me-chiel/MagicWandMod/Software/ESP8266-Hitachi/ESP8266-Hitachi.ino

/*********
  Rui Santos
  Complete project details at https://RandomNerdTutorials.com/esp32-esp8266-web-server-outputs-momentary-switch/
  
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
  The above copyright notice and this permission notice shall be included in all
  copies or substantial portions of the Software.
*********/

/*
Me-Chiel:
This should be possible with an ESP 01S and some extra components.
Maybe in the future I'll have a go at integrating this completely in the Magic Wand.
Added two extra buttons to control the Magic Wand in this sofware.
Be aware, the signals from the Wand are pulled up high to 5V. 
you cannot connect these directly to your ESP module.
*/

#ifdef ESP32
  #include <WiFi.h>
  #include <AsyncTCP.h>
#else
  #include <ESP8266WiFi.h>
  #include <ESPAsyncTCP.h>
#endif
#include <ESPAsyncWebServer.h>
#include "credentials.h"

// REPLACE WITH YOUR NETWORK CREDENTIALS
const char* ssid = WiFi_ssid;
const char* password = WiFi_password;

const int outputD4 = 2;
const int outputD2 = 4;
const int outputD1 = 5;

// HTML web page
const char index_html[] PROGMEM = R"rawliteral(
<!DOCTYPE HTML><html>
  <head>
    <title>ESP Pushbutton Web Server</title>
    <meta name="viewport" content="width=device-width, initial-scale=1">
    <style>
      body { font-family: Arial; text-align: center; margin:0px auto; padding-top: 30px;}
      .button {
        padding: 10px 20px;
        font-size: 24px;
        text-align: center;
        outline: none;
        color: #fff;
        background-color: #2f4468;
        border: none;
        border-radius: 5px;
        box-shadow: 0 6px #999;
        cursor: pointer;
        -webkit-touch-callout: none;
        -webkit-user-select: none;
        -khtml-user-select: none;
        -moz-user-select: none;
        -ms-user-select: none;
        user-select: none;
        -webkit-tap-highlight-color: rgba(0,0,0,0);
      }  
      .button:hover {background-color: #1f2e45}
      .button:active {
        background-color: #1f2e45;
        box-shadow: 0 4px #666;
        transform: translateY(2px);
      }
    </style>
  </head>
  <body>
    <h1>ESP8266 HITACHI Web Server</h1>
    <button class="button" onmousedown="toggleCheckbox('on');" ontouchstart="toggleCheckbox('on');" onmouseup="toggleCheckbox('off');" ontouchend="toggleCheckbox('off');">ON/OFF</button><BR><BR>
    <button class="button" onmousedown="toggleCheckbox('on1');" ontouchstart="toggleCheckbox('on1');" onmouseup="toggleCheckbox('off1');" ontouchend="toggleCheckbox('off1');">+</button><BR><BR>
    <button class="button" onmousedown="toggleCheckbox('on2');" ontouchstart="toggleCheckbox('on2');" onmouseup="toggleCheckbox('off2');" ontouchend="toggleCheckbox('off2');">-</button><BR><BR>
   <script>
   function toggleCheckbox(x) {
     var xhr = new XMLHttpRequest();
     xhr.open("GET", "/" + x, true);
     xhr.send();
   }
  </script>
  </body>
</html>)rawliteral";

void notFound(AsyncWebServerRequest *request) {
  request->send(404, "text/plain", "Not found");
}

AsyncWebServer server(80);

void setup() {
  Serial.begin(115200);
  WiFi.mode(WIFI_STA);
  WiFi.begin(ssid, password);
  if (WiFi.waitForConnectResult() != WL_CONNECTED) {
    Serial.println("WiFi Failed!");
    return;
  }
  Serial.println();
  Serial.print("ESP IP Address: http://");
  Serial.println(WiFi.localIP());
  
  pinMode(outputD4, OUTPUT);//gpio02
  pinMode(outputD2, OUTPUT);//gpio04
  pinMode(outputD1, OUTPUT);//gpio05
  digitalWrite(outputD4, LOW);
  digitalWrite(outputD2, LOW);
  digitalWrite(outputD1, LOW);
  
  // Send web page to client
  server.on("/", HTTP_GET, [](AsyncWebServerRequest *request){
    request->send_P(200, "text/html", index_html);
  });

  // Receive an HTTP GET request
  server.on("/on", HTTP_GET, [] (AsyncWebServerRequest *request) {
    digitalWrite(outputD4, HIGH);
    request->send(200, "text/plain", "ok");
  });

  // Receive an HTTP GET request
  server.on("/off", HTTP_GET, [] (AsyncWebServerRequest *request) {
    digitalWrite(outputD4, LOW);
    request->send(200, "text/plain", "ok");
  });
  
    // Receive an HTTP GET request
  server.on("/on1", HTTP_GET, [] (AsyncWebServerRequest *request) {
    digitalWrite(outputD2, HIGH);
    request->send(200, "text/plain", "ok");
  });

  // Receive an HTTP GET request
  server.on("/off1", HTTP_GET, [] (AsyncWebServerRequest *request) {
    digitalWrite(outputD2, LOW);
    request->send(200, "text/plain", "ok");
  });

  // Receive an HTTP GET request
  server.on("/on2", HTTP_GET, [] (AsyncWebServerRequest *request) {
    digitalWrite(outputD1, HIGH);
    request->send(200, "text/plain", "ok");
  });

  // Receive an HTTP GET request
  server.on("/off2", HTTP_GET, [] (AsyncWebServerRequest *request) {
    digitalWrite(outputD1, LOW);
    request->send(200, "text/plain", "ok");
  });

  server.onNotFound(notFound);
  server.begin();
}

void loop() {
 
}
