me-chiel/MagicWandMod/(commit log)

2023-02-19 added mosfet info
    Added some more info where to get the mosFET's
2023-02-19 Added BOM list to read me
2023-02-19 updated BOM list
2023-02-19 Updated the BOM list
2023-02-19 added ali-express alternatives to BOM
